Rohith45-ch/iitb/docs/3D_PRINTING_CHASSIS_AND_COMPONENTS_ARCHITECTURE.md

# 🖨️ 3D-Printed Multi-Deck Chassis & Component Architecture Blueprint
### Urban Autonomous Mobility Challenge (UAMC) — Techfest, IIT Bombay
**Repository:** [Rohith45-ch/iitb](https://github.com/Rohith45-ch/iitb)  
**Document File Path:** [`docs/3D_PRINTING_CHASSIS_AND_COMPONENTS_ARCHITECTURE.md`](file:///home/rohith/iitb/docs/3D_PRINTING_CHASSIS_AND_COMPONENTS_ARCHITECTURE.md)  
**Hardware Authority:** `Wiring_and_Pin_Map.pdf` (Repo: `Rohith45-ch/iitb`)  
**Revision:** 2.2 (Aligned to `Wiring_and_Pin_Map.pdf` · Outer/Base Layer Reprint Checklist · Corrected 170 mm Wheelbase)  
**Date:** November 7, 2026  

---

> [!IMPORTANT]
> This is a **preliminary layout guide**, not a print-ready CAD drawing. Measure the actual parts and resolve the items marked **NEEDS CONFIRMATION** before modeling or printing the full chassis.

> **Outer-layer reprint quick status — updated 2026-11-07:** Use the corrected **170 mm axle-center wheelbase**. Do not reuse the old 185 mm rear-axle position. Electrical placement is aligned to `/home/rohith/Downloads/Wiring_and_Pin_Map.pdf`: the 5 V buck powers the servo, sonar, and L298N logic; the power bank powers the Pi only; and the E-stop NC contact is before the fuse in the battery line. The outer/base layer may be reprinted only after checking the actual wheel track, steering clearance, motor mounting points, and battery footprint against the checklist in Section 2A.

---

## 2A. Outer/Base Layer Reprint Checklist

Use this checklist before exporting the outer/base layer STL. These are the current locked decisions and the remaining measurements that must come from the physical vehicle.

| Item | Current specification | Before printing |
|---|---|---|
| Wheelbase | **170.0 mm**, front axle center to rear axle center | Mark both axle centerlines in CAD; do not use 185 mm |
| Base envelope | **240 mm length × 110 mm width × 3.5 mm floor** | Treat as a starting envelope; verify wheel and motor overhang |
| Track width | Not safely fixed in the repository | Measure wheel-center to wheel-center and check full steering lock |
| Front servo mount | Raised mount or through-opening; no 18 mm-deep pocket in 3.5 mm floor | Measure the SG90/MG90S body, ears, horn, and linkage before cutting |
| Rear motor mounts | Actual TT motor and axle positions | Measure both motors and confirm wheel alignment/ground clearance |
| Battery cradle | Sized from the actual 3S battery, leads, and connector | Leave removal clearance; do not compress the pack |
| Layer-1 mounting bosses | Six M3 support bosses, 7 mm outer diameter / 3.2 mm hole | Confirm the upper-deck footprint fits the measured electronics |

**Minimum reprint gate:** confirm the 170 mm wheelbase, actual track width, front wheel sweep, servo clearance, and rear motor positions. If any of these are unknown, print a small fit-check piece or mark the part locations on the existing chassis before printing the complete outer layer.

---

## 📌 1. Executive Hardware Specification

### 📋 Reconciled Component Inventory & Placement

| Component | Physical Model / Specification | Deck Location | Role in Autonomous System |
| :--- | :--- | :--- | :--- |
| **High-Level SBC** | **Raspberry Pi 5 (8GB)** (85 × 56 mm) | **Layer 2** (Top Deck) | IPM Lane Tracking, YOLOv8/PilotNet AI, Behavior FSM Planner |
| **Vision Camera** | **Raspberry Pi Camera Rev 1.3** (OV5647 5MP) | **Layer 3** (Elevated Mast) | 120–150 mm elevation, 18° downward tilt, 15-to-22 pin CSI ribbon |
| **Low-Level MCU** | **ESP32 DevKit V1 (30-pin)** | **Layer 1** (Mid Deck) | 20 kHz motor PWM, 50 Hz servo PWM, sonar timing, 150ms watchdog |
| **Steering Actuator** | **Micro Servo 9g (SG90 / MG90S)** | **Layer 0** (Front Center) | Front Ackermann steering angle ($\pm 28^\circ$) via GPIO 18 |
| **Motor Driver** | **L298N Dual H-Bridge Module** | **Layer 1** (Mid Deck) | Drives both TT motors; PWM via GPIO 19, DIR via GPIO 22/23 |
| **Drive Motors** | **2× TT Gear Motors; exact model and stall current unknown** | **Layer 0** (Rear Axle) | Check each motor's voltage and stall current against the L298N and buck converter before driving |
| **Drive Battery** | **3S LiPo 2200 mAh (11.1V / 12.6V)** | **Layer 0** (Center Floor) | High-current main power source (lowest center of gravity) |
| **Motor Regulator** | **7V Buck Converter (3A+)** | **Layer 1** (Mid Deck) | Drops 3S pack to 7V for L298N motor supply (`+12V VS`) |
| **Logic Regulator** | **5V Buck Converter (3A+)** | **Layer 1** (Mid Deck) | Powers servo, HC-SR04 VCC, and L298N 5V logic; remove the L298N 5V jumper |
| **Pi Power Bank** | **2500–3500 mAh, 5V/3A listed output** | **Layer 1** (Mid Deck Rear) | Powers the Pi 5 only through USB-C; do not power the servo from the Pi GPIO header |
| **Obstacle Sonar** | **1× HC-SR04 Ultrasonic Sensor** | **Layer 2** (Front Bumper) | Front-center emergency braking pod (Trig: GPIO 5, Echo: GPIO 35) |
| **E-Stop Switch** | **22 mm Latching E-Stop (2 Contacts)** | **Layer 1/2** (Top Flange) | NC contact in battery line; NO contact to ESP32 GPIO 27 |
| **Inline Fuse** | **10A fuse — rating still needs checking against measured current and wire size** | **Layer 0/1** (next to battery positive terminal) | Protects the battery lead; fit after the E-stop in the positive wire |
| **Prototyping Deck** | **400-Point Solderless Breadboard** | **Layer 1** (Mid Deck) | ESP32 carrier, common GND rail, 1k/2k echo divider, servo cap |
| **Ground Line Sensor**| **SmartElex RLS-06 (6-IR Array)** | **Layer 0** (Under-Nose) | Optional ground recovery sensor (camera handles main lane tracking) |

---

## 📐 2. Master CAD Dimensioning & Fastener Schedule

Every dimension includes standard FDM 3D printing tolerances (+0.2 mm to +0.3 mm on inner diameters to ensure effortless fastener clearance and drop-in fit):

| Component | Physical Dimensions (L × W × H) | Mounting Pattern / Center-to-Center | Fastener Hardware | CAD Modeling Feature / Pocket Tolerances |
| :--- | :--- | :--- | :--- | :--- |
| **Chassis Wheelbase ($L$)** | **170.0 mm** (axle center to axle center; PDF specification) | Use front axle center as $y=0$; rear axle center must be $y=170.0\text{ mm}$ | Axle hardware depends on actual steering and motor parts | **NEEDS CONFIRMATION:** check against the physical chassis, wheels, and axle parts before CAD. |
| **Chassis Track Width ($W$)** | **NEEDS CONFIRMATION** | Measure between wheel centers on the actual chassis; do not use the unverified 135–145 mm range | Depends on actual wheels and axles | Check wheel clearance at full steering lock. |
| **Micro Servo 9g (SG90/MG90S)**| Measure the actual servo; listed body size is approximate | Use actual mounting ears and horn | Fasteners depend on servo ears | A simple 18 mm-deep pocket cannot be cut into the 3.5 mm floor. Design a raised mount or a through-opening with a separate holder; steering linkage geometry still needs to be designed. |
| **2× TT Gear Motors** | 70.0 × 22.0 × 19.0 mm each | 2 transverse bolt holes: **Ø 3.2 mm** | 2× M3 × 30 mm cross-bolts | Dual clamp saddle: **22.5 × 19.5 mm** pocket per motor. |
| **3S LiPo 2200 mAh Battery** | Measure pack including leads and connector | Floor cradle, positioned after deck layout | 20 mm Velcro cinch strap | **NEEDS CONFIRMATION:** set tray size and strap slots from the actual pack; leave room to connect and remove it without squeezing the battery. |
| **L298N Motor Driver** | 43.5 × 43.5 × 26.0 mm (with heatsink) | 4 holes: **37.5 × 37.5 mm** square pattern | 4× M3 × 8 mm standoffs | Clearance under board for solder tails; heatsink airflow slot. |
| **7V Buck Converter (Motor)** | Measure actual board; current rating must be verified | Use actual board holes or cable ties | M3 screws or zip-ties | Size tray from board; confirm converter handles both motors' stall current. |
| **5V Buck Converter (Logic)** | Measure actual board and confirm current rating | Use actual board holes or cable ties | M3 screws or zip-ties | Size tray from board; output supplies sonar and L298N logic. |
| **400-Point Breadboard** | 82.0 × 55.0 × 9.0 mm | Adhesive back foam pad | Recessed snap-lip | Tray: **83.5 × 56.5 × 3.0 mm** recessed well. |
| **ESP32 DevKit V1 (30-pin)** | 52.0 × 28.5 × 13.0 mm | 2.54 mm pitch (25.4 mm pin row span)| Press-fit into breadboard | Straddles center divider of breadboard; leave 2 rows free each side. |
| **Raspberry Pi 5 (8GB)** | 85.0 × 56.0 × 17.0 mm (24 mm w/ cooler) | 4 holes: **58.0 × 49.0 mm** rectangle | 4× M2.5 × 10 mm standoffs | Hole diameter: **Ø 2.8 mm**; bottom cutaway for MicroSD access. |
| **Raspberry Pi Camera Rev 1.3** | 25.0 × 24.0 × 9.0 mm (lens Ø 8.0 mm) | 4 holes: **21.0 × 12.5 mm** rectangle | 4× M2 nylon screws | Lens aperture: **Ø 9.0 mm**; bottom ribbon slot: **17.0 × 2.5 mm**. |
| **HC-SR04 Ultrasonic Module** | 45.0 × 20.0 × 15.0 mm (cylinders: Ø 16.0 mm)| Dual cylinder center spacing: **26.0 mm**| Front friction snap-fit | 2 barrel holes: **Ø 16.4 mm** spaced 26.0 mm on center. |
| **22 mm Latching E-Stop Switch**| Ø 22.0 mm threaded body, Ø 30 mm bezel | Single panel hole | Threaded locking ring | Flange hole: **Ø 22.5 mm**; prominent top-deck position. |
| **2500–3500 mAh LiPo Power Bank**| Measure actual bank | Flat rectangular pack | Straps sized to bank | **NEEDS CONFIRMATION:** size bay from the actual bank; it powers the Pi 5 only. |
| **SmartElex RLS-06 (Optional)** | 135.0 × 20.0 × 12.0 mm | 2 mounting holes: **125.0 mm** apart | 2× M3 screws + spacers | Under-nose bracket: **6.0 – 8.0 mm** track clearance. |

---

## 🏗️ 3. Multi-Deck Sandwich Architecture

The vehicle is partitioned into **4 vertical structural tiers** connected by M3 hexagonal standoffs. Keep signal wiring away from motor and battery wiring where practical; the tier layout alone does not eliminate electrical noise. The final deck arrangement must be checked against the actual component sizes:

```
===================================================================================
                       LAYER 3: VISION MAST (Height: 120–150 mm)
  [ Pi Camera Rev 1.3 ] (18° downward tilt, forward line of sight)
         │ 15-to-22 pin CSI ribbon cable
===================================================================================
                       LAYER 2: COMPUTE & SENSOR DECK (Top Plate)
  • Front Bumper: 1× HC-SR04 Ultrasonic Sonar Pod (Center 0°, GPIO 35 via divider)
  • Center Bay:   Raspberry Pi 5 (8GB) with Active Cooler (M2.5 standoffs)
  • Top Flange:   22 mm Latching E-Stop Kill Switch Button (High-visibility)
===================================================================================
                       LAYER 1: CONTROLLER & POWER REGULATION DECK
  • 400-Point Breadboard (Carries ESP32 DevKit V1 + Voltage Divider + 1000µF Cap)
  • L298N Dual H-Bridge Motor Driver Module (M3 standoffs, heatsink exposed)
  • 7V Buck Converter (Motor Rail) & 5V Buck Converter (Sonar/L298N Logic Rail)
  • 2500–3500 mAh LiPo Power Bank Cradle (Pi 5 only)
===================================================================================
                       LAYER 0: STRUCTURAL BASE CHASSIS (Bottom Floor)
  • Wheelbase: Exactly 170.0 mm (Axle to Axle)
  • Front Axle: Ackermann Steering Knuckles + Micro Servo 9g Pocket (23.5 × 12.5 mm)
  • Center Bay: 3S LiPo 2200 mAh Battery Cradle (Lowest vehicle center of gravity)
  • Rear Axle:  Dual TT Gear Motors (3–9V) clamped in transverse saddles
  • Under-Nose: SmartElex RLS-06 6-IR Ground Line Array (Optional add-on)
===================================================================================
```

---

## 🔍 4. Detailed Layer-by-Layer CAD Modeling Guide

### 🚗 Layer 0: Structural Base Chassis
1. **Perimeter Dimensions:**
   - Length: **240.0 mm**, Width: **110.0 mm**, Floor Plate Thickness: **3.5 mm** — preliminary envelope only; verify against the actual chassis and component layout.
   - Wheelbase: **170.0 mm axle-center to axle-center**, as specified in the PDF. Set the CAD origin at the front axle center ($y=0$) and place the rear axle center at $y=170.0$ mm. The previous rear axle position of $y=185$ mm was incorrect.
2. **Micro Servo 9g Steering Pocket:**
   - Position and orientation: **NEEDS CONFIRMATION** after the actual steering knuckles, wheels, servo, and horn are laid out.
   - Do not model the listed 18 mm depth as a recess in the 3.5 mm floor. Use a raised servo mount or an opening with a separate retaining bracket, sized from the actual servo.
   - Set mounting holes from the actual servo ears. Design the horn and tie rods so both front wheels turn without binding or tire rub through the required steering range.
3. **TT Gear Motor Clamps:**
   - Position: Rear axle centerline at $y = 170.0\text{ mm}$ from the front axle center.
   - Saddle locations and dimensions: **NEEDS CONFIRMATION** from the actual TT motors, axles, and wheels; check wheel alignment and ground clearance.
   - Dual M3 through-bolt channels (spacing **30.0 mm**) to clamp each motor firmly against torque reaction.
4. **3S LiPo Battery Tray:**
   - Position: Centerline at $y = 70.0\text{ mm}$ to $y = 150.0\text{ mm}$.
   - Internal well dimensions: **NEEDS CONFIRMATION** from the actual battery, including its lead and connector; allow clearance for removal and do not compress the pack.
   - Include 4 slots (**22.0 × 3.0 mm**) for standard 20 mm Velcro cinch straps.
5. **Deck Standoff Bosses:**
   - 6× M3 mounting bosses (Ø 7.0 mm outer, Ø 3.2 mm inner hole) located along perimeter rails to support Layer 1.

---

### ⚡ Layer 1: Controller & Power Deck (Mid Plate)
1. **Breadboard Well:**
   - Recessed tray: **83.5 mm × 56.5 mm × 2.5 mm depth**.
   - Mount 400-point breadboard using its adhesive backing.
   - ESP32 DevKit V1 plugs into breadboard straddling the center divider groove.
2. **L298N Motor Driver Mounting:**
   - Footprint: **44.0 × 44.0 mm** area.
   - 4× M3 standoff holes on a **37.5 × 37.5 mm** square grid.
   - Provide a **20 × 20 mm central cutout** beneath the board for terminal soldering pin relief and convection cooling.
3. **Dual Buck Converter Trays (7V and 5V):**
   - Side-by-side cradles: each **68.0 × 38.0 mm**.
   - M3 mounting holes or cable-tie anchor channels.
   - Leave clearance around multiturn trim pots so output voltages can be adjusted with a screwdriver while mounted.
4. **Power Bank Tray:**
   - Size from the actual power bank. Leave USB-C connector and cable access, strap space, and room to remove the bank.
5. **Full deck fit check:**
   - The breadboard, L298N, two buck converters, and Pi power bank are listed for Layer 1, but their placement has not been checked. Make a top-view layout from measured part outlines before fixing the deck outline or printing it.
5. **E-Stop Panel Flange:**
   - Raised rear/side boss with a **Ø 22.5 mm** clearance hole for the 22 mm latching emergency kill button.

---

### 🧠 Layer 2: Compute & Sensor Deck (Top Plate)
1. **Raspberry Pi 5 Standoff Posts:**
   - 4× raised cylindrical posts (height 6.0 mm, outer Ø 6.0 mm).
   - Hole pattern: **58.0 mm × 49.0 mm** rectangle with **Ø 2.8 mm** holes for M2.5 brass standoffs.
   - Provide a **30.0 × 15.0 mm rectangular cutaway** underneath the MicroSD card slot for easy card insertion/removal without removing the board.
2. **Front Bumper & Ultrasonic Pod:**
   - Integrated forward curved bumper extending 25 mm ahead of front wheels.
   - Two cylindrical bores: **Ø 16.4 mm**, center-to-center distance **26.0 mm**, wall thickness 2.0 mm.
   - Rear access pocket allowing the 4-pin right-angle header of the HC-SR04 to plug in cleanly.

---

### 📷 Layer 3: Vision Mast & Camera Bracket
1. **Mast Structure:**
   - Rigid A-frame or hollow rectangular tower (height **130.0 mm**, base width **45.0 mm**).
   - Central internal channel (**20.0 × 4.0 mm**) to route the delicate CSI ribbon cable safely away from tire spray.
2. **Pi Camera Rev 1.3 Faceplate:**
   - Dimensions: **30.0 × 30.0 mm** angled faceplate with fixed **18.0° downward tilt**.
   - 4× M2 screw holes on a **21.0 × 12.5 mm** grid.
   - Center lens aperture: **Ø 9.0 mm**.
   - Bottom slot (**18.0 × 2.5 mm**) for 15-pin ribbon exit.

---

## 🔌 5. Master Wiring & Electrical Interconnect Schematic

```
                         ┌────────────────────────────────────────┐
                         │   2500–3500 mAh LiPo Power Bank        │
                         └───────────────────┬────────────────────┘
                              │ 5V / 3A USB-C
                              ▼
                     [ Raspberry Pi 5 ]
                                             │
                                USB Cable    │   15-to-22 Pin Ribbon
                              (Serial Data)  │
                                             ▼
                      ┌──────────────────────┴──────────────────────┐
                      │                                             │
                      ▼                                             ▼
            [ ESP32 DevKit V1 ]                          [ RPi Cam Rev 1.3 ]
         (on 400-pt Breadboard)                         (on Layer 3 Mast)
          ├── GPIO 18 (PWM 50Hz) ──────► Micro Servo 9g (Signal)
          ├── GPIO 19 (PWM 20kHz) ─────► L298N ENA + ENB (Speed)
          ├── GPIO 22 (Digital Out) ───► L298N IN1 + IN3 (Dir A)
          ├── GPIO 23 (Digital Out) ───► L298N IN2 + IN4 (Dir B)
          ├── GPIO 5  (Trigger)  ──────► HC-SR04 Center Sonar Trig
          ├── GPIO 35 (Echo Center)◄─── HC-SR04 Center Sonar Echo (via 1k/2k Divider)
          └── GPIO 27 (Input Pullup)◄── Hardware E-Stop Switch (Active-LOW)

┌────────────────────────────────────────────────────────────────────────┐
│                      3S LiPo 2200 mAh (11.1V / 12.6V)                  │
└───────────────────────────────────┬────────────────────────────────────┘
                                    │ (+) Positive Wire
                                    ▼
                         [ E-Stop Switch NC Contact ]
                                    │
                                    ▼
                         [ 10A Inline Fuse ]
                                    │
               ┌────────────────────┴────────────────────┐
               │                                         │
               ▼                                         ▼
       [ 7V Buck Converter ]                     [ 5V Buck Converter ]
       (Adjusted to 7.00V)                       (Adjusted to 5.00V)
               │                                         │
               ▼                                         ├──► Servo (+) + 470–1000µF capacitor
       L298N +12V (VS) Terminal                    ├──► HC-SR04 VCC (5V)
               │                                         └──► L298N +5V Logic [Jumper Removed]
               ▼
     [ Left & Right TT Motors ]

Power-bank ground, Pi ground, ESP32 ground (through USB), L298N ground, buck grounds, servo ground, and sonar ground must be common. The 3S LiPo positive path is: E-stop NC contact, then 10 A fuse, then the buck converters.
```

> **Power checks still required:** The Pi power bank is Pi-only. The 5 V buck must power the servo, HC-SR04, and L298N logic. The E-stop must cut all motor-battery-powered rails because its NC contact is before the fuse. Measure motor stall current and verify driver, converter, wiring, fuse, and switch ratings. The listed 10 A fuse is not confirmed until those ratings are checked.

---

## 🖨️ 6. 3D Print Manufacturing Slicing Profile

| Slicer Parameter | Recommended Value | Engineering Justification |
| :--- | :--- | :--- |
| **Material / Filament** | **PETG** (or **PLA+**) | Heat resistance near motors (>75°C vs PLA's 55°C deformation) and high layer impact toughness. |
| **Layer Height** | **0.20 mm** (0.28 mm for draft) | Smooth surface finish for screw threads and tight tolerance on sensor pockets. |
| **Perimeter Walls** | **4 to 5 walls (1.6 – 2.0 mm)** | **Critical:** Screws thread directly into 3D-printed plastic walls; 2 walls will strip immediately. |
| **Top & Bottom Layers** | **4 Top / 4 Bottom** | Prevents deck flexing under battery and motor clamping loads. |
| **Infill Density** | **35% – 45%** | Maximizes torsional stiffness to ensure accurate steering geometry. |
| **Infill Pattern** | **Gyroid** or **Cubic** | Uniform 3-dimensional stress resistance without directional failure planes. |
| **Supports** | Tree / Organic Supports | Enable only for overhang angles > 55° (camera tilt bracket and bumper curvature). |
| **Print Bed Adhesion** | Textured PEI sheet with 5 mm Brim | Prevents corner lifting / warping on the long 240 mm chassis baseplate. |

---

## 🚀 7. Step-by-Step Mechanical Assembly Sequence

### Phase 1: Base Chassis Build (Layer 0)
1. **Fit Steering Servo:** Install the servo in the raised mount or separate holder designed to fit the measured servo. Attach the horn at neutral and connect the designed tie rods. Check that neither front wheel binds or rubs at full steering lock.
2. **Mount TT Motors:** Insert the two TT gear motors into the rear axle saddles. Insert 2× M3 × 30 mm cross-bolts per motor and tighten nylon locknuts. Press rear drive wheels onto motor double-flat axles.
3. **Install Drive Battery:** Place the 3S LiPo 2200 mAh into the central cradle. Cinch securely with a 20 mm Velcro strap.
4. **Install Standoffs:** Thread 6× M3 × 30 mm female-female hex standoffs into the perimeter bosses.

### Phase 2: Power & Controller Deck Assembly (Layer 1)
1. **Install Mid Plate:** Place the Layer 1 plate over the standoffs and secure with M3 countersunk screws.
2. **Mount Breadboard & ESP32:** Peel the adhesive backing off the 400-point breadboard and press it into the recessed tray. Seat the ESP32 DevKit V1 straddling the center channel.
3. **Mount L298N & Bucks:** Fasten the L298N module using 4× M3 × 8 mm standoffs. Fasten both buck converters into their trays using zip-ties or M3 screws.
4. **Wire Power & E-Stop:** Install the 22 mm E-Stop button in the flange hole. Wire the battery positive through the E-stop NC contact first, then through the fuse placed close to the battery. Wire the NO contact to ESP32 GPIO 27. Confirm the fuse and switch ratings against the actual wiring and motor current before use.
5. **Adjust Buck Voltages:** Connect battery and use a multimeter to adjust the 7V buck to **7.00V** and the 5V buck to **5.00V** before making connections to components.
6. **Install Upper Standoffs:** Thread 4× M3 × 35 mm hex standoffs into the Layer 1 top bosses.

### Phase 3: Compute & Vision Deck Assembly (Layer 2 & 3)
1. **Mount Ultrasonic Sensor:** Push the HC-SR04 barrels into the front bumper holes until seated flush. Wire TRIG to ESP32 GPIO 5 and ECHO through the 1kΩ/2kΩ divider to GPIO 35.
2. **Mount Raspberry Pi 5:** Bolt the Pi 5 to the 4× M2.5 standoffs. Ensure the Active Cooler is mounted and the MicroSD card is accessible.
3. **Assemble Camera Mast:** Bolt the Layer 3 camera mast to the front of Layer 2. Fasten the Pi Camera Rev 1.3 to the 18° tilted faceplate using 4× M2 nylon screws.
4. **Route Camera Ribbon:** Route the 15-to-22 pin CSI adapter cable down through the mast channel and connect it to Pi 5 port `CAM1`.

### Phase 4: Final Interconnect & Verification
1. **Connect Data Link:** Plug a short USB-A to Micro-USB cable between a Pi 5 USB-A port and the ESP32 Micro-USB port.
2. **Connect Actuator Jumpers:** Wire GPIO 18 to Servo Signal; GPIO 19 to L298N ENA+ENB; GPIO 22 to IN1+IN3; GPIO 23 to IN2+IN4.
3. **Common Ground Verification:** Confirm with a continuity meter that ESP32 GND, L298N GND, battery (−), and buck GNDs are all connected.
4. **Execute Pre-Flight Diagnostic:**
   ```bash
   ssh rohith@10.94.129.58
   cd ~/iitb && git pull origin main
   python3 scripts/detect_hardware.py
   python3 scripts/verify_system_ready.py
   ```
