Rohith45-ch/iitb/docs/ROUND1_ARCHITECTURE_AND_BUILD_GUIDE.md

# 🏛️ Round 1 Complete System Architecture & Build Guide
### Urban Autonomous Mobility Challenge (UAMC) — Techfest, IIT Bombay
**Vehicle Model:** AML-Rover-V1  
**Target:** Round 1 Qualification (Top 25 Teams)  
**Hardware Profile:** Raspberry Pi 5 (8GB) + ESP32 DevKit V1 + L298N + 2× TT Gear Motors + 3S LiPo 2200mAh + Single Camera + HC-SR04  

---

## 1. Executive Summary & Objective

This document defines the complete end-to-end hardware and software architecture specifically optimized for **Round 1 of the Urban Autonomous Mobility Challenge (UAMC)**.

For Round 1, the competition demands demonstrating:
1. **Autonomous Lane Following:** Continuous centering between white/yellow road markings without crossing lane boundaries.
2. **Controlled Obstacle Halt:** Smooth deceleration and stopping before a static obstacle (> 15 cm clearance) with zero remote intervention.
3. **Safety Watchdog / E-Stop:** Demonstrable emergency stop capability.

This architecture runs **100% on the hardware you currently have in hand**, eliminating non-essential components (such as the MPU6050 IMU and Logic Level Shifter) for this stage, ensuring zero blocking dependencies.

---

## 2. End-to-End Architecture Diagram

```mermaid
flowchart TD
    subgraph Power["⚡ Power Subsystem"]
        BAT["3S LiPo 2200 mAh (11.1V nominal)"] -->|"NC contact → 10A Fuse"| BUCK7["7V Buck Converter"]
        BAT -->|"NC contact → 10A Fuse"| BUCK5["5V Buck Converter"]
        PB["5V 3A+ Power Bank"] -->|"USB-C Cable"| RPI["Raspberry Pi 5 (8GB)"]
        BUCK7 -->|"Motor Supply"| L298N["L298N Motor Driver"]
        BUCK5 -->|"Logic + Servo + Sonar"| SERVO["Steering Servo SG90/MG90S"]
        BUCK5 -->|"5V VCC"| HC["HC-SR04 Ultrasonic"]
        BUCK5 -->|"Logic 5V (jumper removed)"| L298N
    end

    subgraph RPi5["🧠 High-Level Compute (Raspberry Pi 5)"]
        CAM["Pi Camera Rev 1.3 (CSI)"] -->|"OpenCV (640x480 @ 30 FPS)"| PERC["Perception Engine"]
        PERC --> IPM["Lane Detector (IPM + Polyfit)"]
        PERC --> AI["Lightweight AI / Rule-Based Detector"]
        IPM & AI --> FSM["Behavior Planner (FSM)"]
        FSM --> CTRL["Pure Pursuit + Longitudinal PID"]
        CTRL --> BRIDGE["Serial Bridge (USB, /dev/ttyUSB0)"]
    end

    subgraph ESP32["⚡ Low-Level Real-Time Controller (ESP32 DevKit V1)"]
        CORE0["Core 0: Sensor Processing\n(Median-5 + EMA Filter)"]
        CORE1["Core 1: Actuation & Safety\n(20kHz L298N PWM + 150ms E-Stop Watchdog)"]
    end

    subgraph ActuatorsSensors["🚗 Vehicle Chassis & Actuation"]
        HC -->|"Echo (GPIO35 via divider) / Trig (GPIO5)"| CORE0
        CORE1 -->|"20 kHz PWM GPIO19 → ENA/ENB"| L298N
        CORE1 -->|"DIR_A GPIO22, DIR_B GPIO23"| L298N
        CORE1 -->|"50 Hz PWM GPIO18"| SERVO
        L298N -->|"OUT1/2 Left Motor"| MOTL["Left TT Gear Motor"]
        L298N -->|"OUT3/4 Right Motor"| MOTR["Right TT Gear Motor"]
    end

    BRIDGE <== "USB-A to Micro-USB Cable\n(/dev/ttyUSB0 @ 115200 baud)" ==> CORE1
```

---

## 3. Hardware Wiring & Electrical Pinout

The connection between the Raspberry Pi 5 and ESP32 DevKit is handled over a standard **USB-A to Micro-USB cable**, which handles both data communication and 5V power for the ESP32.

### A. Power Distribution Architecture
| Power Source | Consumer | Voltage / Current | Purpose |
| :--- | :--- | :--- | :--- |
| **3S LiPo 2200 mAh** | 7V Buck Converter → L298N +12V(VS) | 11.1V nominal, set buck to 7V | High-current TT motor supply |
| **5V Buck Converter** | Steering Servo | 5.0V regulated | Powers servo (+ 470-1000µF cap) and HC-SR04; L298N logic |
| **5V 3A+ Power Bank** | Raspberry Pi 5 | 5.0V USB-C | Clean isolated power for Pi 5 compute and camera |
| **Raspberry Pi 5 USB Port** | ESP32 Micro-USB | 5.0V USB VBUS | Powers ESP32 logic and sensor rail |

### B. ESP32 Pin Connections
| Component | Signal Name | ESP32 Pin | Function / Protocol |
| :--- | :--- | :--- | :--- |
| **Steering Servo** | PWM Signal (White/Orange) | **GPIO 18** | 50 Hz PWM (`LEDC_CHANNEL_0`) |
| **Steering Servo** | Ground (Black/Brown) | **GND** | Common Ground |
| **L298N ENA + ENB | PWM Speed (20 kHz) | GPIO 19 | 20 kHz PWM (LEDC_CHANNEL_1, 0–255 duty)) |
| **L298N GND** | Ground | **GND** | Common Ground — must join all other GNDs |
| **HC-SR04 Ultrasonic** | VCC | **VIN (5V)** | Ultrasonic 5V supply |
| **HC-SR04 Ultrasonic** | GND | **GND** | Ground |
| **HC-SR04 Ultrasonic** | Trigger | **GPIO 5** | 10 µs Trigger Pulse (`PIN_US_TRIG`) |
| **HC-SR04 Ultrasonic** | Echo | **GPIO 35** | Center Front Echo Return (`PIN_US_ECHO_CENTER`) |

---

## 4. Software Stack & Data Contracts

```mermaid
sequenceDiagram
    participant Cam as USB Camera
    participant RPi as Raspberry Pi 5 (Python)
    participant USB as USB Serial Bridge (115200)
    participant ESP as ESP32 (FreeRTOS)
    participant HW as Servo & L298N

    loop 30 Hz Control Loop
        Cam->>RPi: Capture Raw Frame (640x480 @ 30 FPS)
        RPi->>RPi: 1. IPM Perspective Warp & Color Masking<br>2. Centerline Polynomial Fit<br>3. Compute Target Steering Angle & Target Speed
        ESP->>USB: Send Telemetry `#TEL,<dist_l>,<dist_c>,<dist_r>,<yaw>,<estop>*`
        USB->>RPi: Parse Ultrasonic Distance (< 20 cm triggers Stop FSM)
        RPi->>USB: Send Command `#CMD,<steer_norm>,<throttle_norm>,<estop_flag>*`
        USB->>ESP: ESP32 Core 1 Decodes Packet
        ESP->>HW: Write 50 Hz PWM to Servo (GPIO 18); 20 kHz PWM to L298N ENA/ENB (GPIO 19) + DIR_A/B (GPIO 22/23)
    end
```

### Serial Packet Protocol
* **Raspberry Pi → ESP32 Command (`#CMD`):**
  ```text
  #CMD,<steering_normalized>,<throttle_normalized>,<estop_flag>*\n
  ```
  * `steering_normalized`: Float from `-1.0` (Full Left) to `+1.0` (Full Right).
  * `throttle_normalized`: Float from `-1.0` (Full Reverse/Brake) to `+1.0` (Full Forward).
  * `estop_flag`: Integer `0` (Normal operation) or `1` (Emergency Stop).

* **ESP32 → Raspberry Pi Telemetry (`#TEL`):**
  ```text
  #TEL,<dist_left>,<dist_center>,<dist_right>,<dist_side>,<enc_left>,<enc_right>,<yaw>,<estop>*\n
  ```
  * Distances in meters (filtered via 5-sample median filter + EMA).
  * `estop`: `1` if the 150 ms hardware watchdog triggered or hardware stop activated.

---

## 5. Step-by-Step Round 1 Bring-Up Plan

### Step 1: Upload Firmware to ESP32
1. Connect ESP32 DevKit to laptop using the Micro-USB cable.
2. Open `firmware/esp32_firmware/esp32_vehicle_controller.ino` in Arduino IDE.
3. Select Board: **ESP32 Dev Module** and correct serial port.
4. Click **Upload** and verify `Flash done`.

### Step 2: Calibrate Camera on Vehicle
1. Place vehicle on flat floor with marked lane lines ($35\text{ cm}$ apart).
2. Run camera calibration utility:
   ```bash
   python3 scripts/calibrate_camera.py --camera-id 0
   ```
3. Adjust IPM trapezoid coordinates to generate parallel lane lines in bird's-eye view. Values automatically save to `config/rpi_tuning.py`.

### Step 3: Run Full System Verification
Connect the ESP32 to the Raspberry Pi 5 USB port and execute:
```bash
python3 scripts/detect_hardware.py
python3 scripts/verify_system_ready.py
```
Verify that all 5 stages report `[PASS]`.

### Step 4: Record Qualification Video
Run the qualification telemetry video recorder:
```bash
python3 scripts/record_qualification_run.py --output-video round1_submission.mp4
```
This records real-time camera footage with superimposed steering angles, detected lane polynomials, and ultrasonic distance telemetry suitable for the Round 1 submission video.

---

## 6. Strategic Recommendations & Enhancements

### 💡 A. Recommended AI Module Selection for Round 1
| Vision Approach | Computational Load on Pi 5 | Recommendation | Rationale |
| :--- | :---: | :---: | :--- |
| **Classical CV (IPM + Polyfit)** | **~5% CPU (60+ FPS)** | 🟢 **Primary Driver** | Deterministic, highly robust on tape tracks, zero frame lag. Ideal for smooth lane tracking. |
| **YOLOv8-Nano (`models/yolov8n.onnx`)** | **~25% CPU (25–30 FPS)** | 🟡 **Optional Secondary** | Run concurrently for obstacle and sign identification. Pre-converted and verified in the repo. |
| **PilotNet (`models/pilotnet_steering.onnx`)** | **~10% CPU (45 FPS)** | ⚪ **Defer to Round 2** | Neural steering requires extensive track-specific behavioral cloning data. |

> **Best Approach for Round 1:** Use **Classical IPM Lane Detection** for primary steering and **Ultrasonic sensing** for obstacle stopping. This guarantees top-tier reliability for the qualifying video.

---

### 💡 B. Software Enhancements to Insert
1. **Auto-Start on Boot (Systemd Service):**
   * Configure a systemd service (`uamc_autostart.service`) to start `run_autonomous.py` automatically on boot when the vehicle power bank is plugged in, eliminating the need for laptop SSH during video recording.
2. **Web-Based Live Telemetry Stream:**
   * Run a lightweight MJPEG stream on port `8080` so team members can inspect the vehicle's perspective live from any smartphone connected to the Pi's Wi-Fi hotspot.

---

### 💡 C. Hardware Upgrades: Round 1 vs. Round 2 (On-Site Finals)
1. **Round 1 (Immediate - Confirmed In Hand):**
   * Raspberry Pi 5 + ESP32 DevKit v1 + USB Cable.
   * Single front HC-SR04 ultrasonic sensor.
   * Steering servo (SG90/MG90S) + L298N + 2x TT Gear Motors + 3S LiPo 2200mAh + 7V buck + 5V buck + 5V Power Bank.
2. **Round 2 (On-Site Finals at IIT Bombay):**
   * **MPU6050 IMU:** Add to ESP32 I²C bus (`SDA=GPIO 21`, `SCL=GPIO 22`) for slip compensation and yaw gyro integration.
   * **BSS138 Bidirectional Logic Level Shifter:** Place between HC-SR04 Echo pins (5V) and ESP32 GPIOs (3.3V) for long-term electrical safety.
   * **Optical Wheel Encoders:** Attach to rear drive axle for dead-reckoning odometry when crossing unmarked intersections.
