Rohith45-ch/iitb/firmware/esp32_firmware/esp32_vehicle_controller.ino

/*
  Urban Autonomous Mobility Challenge (UAMC) - ESP32 Real-Time Vehicle Controller
  Platform: ESP32 (Dual-Core 240MHz, FreeRTOS)
  Target: UAMC 1:10 Autonomous Vehicle

  Architecture:
  - Core 0: Non-blocking ultrasonic ranging, encoder tracking, and telemetry formatting.
  - Core 1: High-speed UART communication, watchdog monitor, and high-frequency PWM actuation.
*/

#include <Arduino.h>
#include "esp32_config.h"
#include "tinyml_motion.h"
#include "ultrasonic_filter.h"

// ==========================================
// SHARED STATE & THREAD SYNCHRONIZATION
// ==========================================
volatile long encoderTicksLeft = 0;
volatile long encoderTicksRight = 0;
portMUX_TYPE muxEncoder = portMUX_INITIALIZER_UNLOCKED;

volatile float g_us_left = 2.0f;
volatile float g_us_center = 2.0f;
volatile float g_us_right = 2.0f;
volatile float g_us_side = 0.20f;
volatile bool g_estop_button_pressed = false;

// Edge AI & Outlier Filter Instances
UltrasonicFilter filterLeft;
UltrasonicFilter filterCenter;
UltrasonicFilter filterRight;
UltrasonicFilter filterSide;
TinyMLMotionClassifier motionClassifier;
volatile VehicleMotionState g_motion_state = MOTION_NOMINAL;

// Command Watchdog State
volatile unsigned long lastCommandMillis = 0;
volatile bool watchdogTripped = false;

// ==========================================
// INTERRUPT SERVICE ROUTINES (ISRs)
// ==========================================
void IRAM_ATTR isrEncoderLeft() {
  portENTER_CRITICAL_ISR(&muxEncoder);
  encoderTicksLeft++;
  portEXIT_CRITICAL_ISR(&muxEncoder);
}

void IRAM_ATTR isrEncoderRight() {
  portENTER_CRITICAL_ISR(&muxEncoder);
  encoderTicksRight++;
  portEXIT_CRITICAL_ISR(&muxEncoder);
}

// ==========================================
// ACTUATOR OUTPUT FUNCTIONS
// ==========================================
void setSteeringNormalized(float norm) {
  // norm is in [-1.0 (left), +1.0 (right)]
  norm = constrain(norm, -1.0f, 1.0f);
  // Map norm to microseconds [1000us - 2000us]
  float us = SERVO_MID_US + (norm * (SERVO_MAX_US - SERVO_MID_US));
  // Convert us to LEDC 16-bit duty cycle at 50Hz (Period = 20,000 us)
  // duty = (us / 20000) * 65535
  uint32_t duty = (uint32_t)((us / 20000.0f) * 65535.0f);
  ledcWrite(PIN_STEER_SERVO, duty);
}

void setMotorThrottle(float norm) {
  norm = constrain(norm, -1.0f, 1.0f);

#if USE_ESC_MOTOR_DRIVER
  // Standard RC ESC: 50 Hz PWM with 1000us - 2000us pulse width
  float us = ESC_NEUTRAL_US;
  if (abs(norm) < ESC_DEADBAND_NORM) {
    us = ESC_NEUTRAL_US;
  } else if (norm > 0.0f) {
    // Forward mapping from neutral up to safe forward speed limit
    us = ESC_NEUTRAL_US + (norm * (ESC_FORWARD_SAFE_CAP_US - ESC_NEUTRAL_US));
  } else {
    // Reverse / Dynamic Braking
    us = ESC_NEUTRAL_US + (norm * (ESC_NEUTRAL_US - ESC_REVERSE_MAX_US));
  }
  // Convert microseconds to 16-bit LEDC duty at 50 Hz (20,000 us period)
  uint32_t duty = (uint32_t)((us / 20000.0f) * 65535.0f);
  ledcWrite(PIN_MOTOR_PWM, duty);

#else
  // L298N Dual-wire H-Bridge (USE_ESC_MOTOR_DRIVER == 0)
  // Scaling accounts for MOTOR_MIN_START_PWM to overcome TT gearbox static friction
  if (abs(norm) < 0.05f) {
    digitalWrite(PIN_MOTOR_DIR_A, LOW);
    digitalWrite(PIN_MOTOR_DIR_B, LOW);
    ledcWrite(PIN_MOTOR_PWM, 0);
  } else if (norm > 0.0f) {
    // Forward: IN1/IN3 HIGH, IN2/IN4 LOW
    digitalWrite(PIN_MOTOR_DIR_A, HIGH);
    digitalWrite(PIN_MOTOR_DIR_B, LOW);
    uint32_t pwm = (uint32_t)(MOTOR_MIN_START_PWM + norm * (MOTOR_MAX_SAFE_PWM - MOTOR_MIN_START_PWM));
    pwm = constrain(pwm, 0, MOTOR_MAX_SAFE_PWM);
    ledcWrite(PIN_MOTOR_PWM, pwm);
  } else {
    // Reverse: IN1/IN3 LOW, IN2/IN4 HIGH
    digitalWrite(PIN_MOTOR_DIR_A, LOW);
    digitalWrite(PIN_MOTOR_DIR_B, HIGH);
    uint32_t pwm = (uint32_t)(MOTOR_MIN_START_PWM + abs(norm) * (MOTOR_MAX_SAFE_PWM - MOTOR_MIN_START_PWM));
    pwm = constrain(pwm, 0, MOTOR_MAX_SAFE_PWM);
    ledcWrite(PIN_MOTOR_PWM, pwm);
  }
#endif
}

// ==========================================
// CORE 0 TASK: SENSOR ACQUISITION
// ==========================================
float readUltrasonic(int echoPin) {
  digitalWrite(PIN_US_TRIG, LOW);
  delayMicroseconds(2);
  digitalWrite(PIN_US_TRIG, HIGH);
  delayMicroseconds(10);
  digitalWrite(PIN_US_TRIG, LOW);

  long duration = pulseIn(echoPin, HIGH, 20000); // 20ms timeout (~3.4m)
  if (duration <= 0) return 3.0f;
  return (duration * 0.0343f) / 200.0f;
}

void TaskSensorAcquisition(void *pvParameters) {
  while (true) {
#if SINGLE_CENTER_SONAR_ONLY
    // PDF §1, §3, §6 item 4, §7: Only single Center Sonar fitted.
    // Unfitted sonars (left, right, side) are bypassed to avoid 60ms timeout lag and floating-pin false stops.
    float raw_c = readUltrasonic(PIN_US_ECHO_CENTER);
    g_us_center = filterCenter.filter(raw_c);
    g_us_left = 3.0f;
    g_us_right = 3.0f;
    g_us_side = 3.0f;
    vTaskDelay(pdMS_TO_TICKS(30));
#else
    // Multi-sonar mode (when all 4 sensors are physically wired)
    float raw_l = readUltrasonic(PIN_US_ECHO_LEFT);
    g_us_left = filterLeft.filter(raw_l);
    vTaskDelay(pdMS_TO_TICKS(10));

    float raw_c = readUltrasonic(PIN_US_ECHO_CENTER);
    g_us_center = filterCenter.filter(raw_c);
    vTaskDelay(pdMS_TO_TICKS(10));

    float raw_r = readUltrasonic(PIN_US_ECHO_RIGHT);
    g_us_right = filterRight.filter(raw_r);
    vTaskDelay(pdMS_TO_TICKS(10));

    float raw_s = readUltrasonic(PIN_US_ECHO_SIDE);
    g_us_side = filterSide.filter(raw_s);
    vTaskDelay(pdMS_TO_TICKS(10));
#endif

    // 2. Hardware Emergency Stop button (PDF §3, §6 item 6: active-LOW)
    g_estop_button_pressed = (digitalRead(PIN_ESTOP_INPUT) == LOW);

    // 3. TinyML Collision & Rollover Check (100 Hz baseline)
    g_motion_state = motionClassifier.classify(0.0f, 0.0f, 1.0f, 0.0f, 0.0f);
  }
}

// ==========================================
// SETUP & CORE 1 (MAIN LOOP)
// ==========================================
void setup() {
  // Primary Serial for USB debug & secondary for RPi UART
  Serial.begin(115200);
  Serial2.begin(115200, SERIAL_8N1, PIN_UART_RX, PIN_UART_TX);

  // E-Stop Pin Setup (PDF §6 item 6: internal pullup + external 10k to 3.3V)
  pinMode(PIN_ESTOP_INPUT, INPUT_PULLUP);

  // Ultrasonic GPIO Setup (PDF §3: Pin 5 TRIG out, Pin 35 ECHO in via 1k/2k divider)
  pinMode(PIN_US_TRIG, OUTPUT);
  digitalWrite(PIN_US_TRIG, LOW);
  pinMode(PIN_US_ECHO_CENTER, INPUT);

  // Actuator LEDC Setup (Arduino-ESP32 v3.x API: ledcAttach replaces ledcSetup+ledcAttachPin)
  ledcAttach(PIN_STEER_SERVO, SERVO_LEDC_FREQ, SERVO_LEDC_RES);

#if USE_ESC_MOTOR_DRIVER
  // 1/10 RC ESC Setup: 50 Hz, 16-bit LEDC on Pin 19
  ledcAttach(PIN_MOTOR_PWM, ESC_LEDC_FREQ, ESC_LEDC_RES);

  // Arm ESC by outputting neutral pulse (1500 us)
  setSteeringNormalized(0.0f);
  setMotorThrottle(0.0f);
  Serial.println(F("[ESP32] Arming ESC (1500us neutral calibration)..."));
  delay(1500);
  Serial.println(F("[ESP32] ESC armed and vehicle ready."));
#else
  // L298N Dual H-Bridge Setup (USE_ESC_MOTOR_DRIVER == 0, per PDF §3, §5, §6)
  pinMode(PIN_MOTOR_DIR_A, OUTPUT);
  pinMode(PIN_MOTOR_DIR_B, OUTPUT);
  digitalWrite(PIN_MOTOR_DIR_A, LOW);
  digitalWrite(PIN_MOTOR_DIR_B, LOW);
  ledcAttach(PIN_MOTOR_PWM, MOTOR_LEDC_FREQ, MOTOR_LEDC_RES);
  setSteeringNormalized(0.0f);
  setMotorThrottle(0.0f);
  Serial.println(F("[ESP32] L298N Motor Driver configured (20 kHz PWM on Pin 19)."));
#endif

  // Encoders (PDF §6 item 5: only attach if physically fitted)
#if ENABLE_WHEEL_ENCODERS
  pinMode(PIN_ENCODER_LEFT, INPUT_PULLUP);
  pinMode(PIN_ENCODER_RIGHT, INPUT_PULLUP);
  attachInterrupt(digitalPinToInterrupt(PIN_ENCODER_LEFT), isrEncoderLeft, RISING);
  attachInterrupt(digitalPinToInterrupt(PIN_ENCODER_RIGHT), isrEncoderRight, RISING);
#endif

  // Launch Core 0 Sensor Task (Pinned to Core 0)
  xTaskCreatePinnedToCore(
    TaskSensorAcquisition,
    "SensorTask",
    4096,
    NULL,
    1,
    NULL,
    0
  );

  lastCommandMillis = millis();
}

unsigned long lastTelemetryMillis = 0;

void loop() {
  // 1. Process Incoming Commands from Raspberry Pi
  Stream &comm = Serial2.available() ? Serial2 : Serial;

  if (comm.available()) {
    String line = comm.readStringUntil('\n');
    line.trim();

    if (line.startsWith("#CMD,") && line.endsWith("*")) {
      String payload = line.substring(5, line.length() - 1);
      int c1 = payload.indexOf(',');
      int c2 = payload.indexOf(',', c1 + 1);

      if (c1 > 0 && c2 > 0) {
        float steer = payload.substring(0, c1).toFloat();
        float throttle = payload.substring(c1 + 1, c2).toFloat();
        int estop = payload.substring(c2 + 1).toInt();

        bool motionAnomaly = (g_motion_state == MOTION_COLLISION_DETECTED || g_motion_state == MOTION_ROLLOVER_DETECTED);
        if (estop == 1 || g_estop_button_pressed || motionAnomaly) {
          setMotorThrottle(0.0f);
          setSteeringNormalized(0.0f);
        } else {
          setSteeringNormalized(steer);
          setMotorThrottle(throttle);
        }

        lastCommandMillis = millis();
        watchdogTripped = false;
      }
    }
  }

  // 2. Hardware Watchdog Check
  if (millis() - lastCommandMillis > WATCHDOG_TIMEOUT_MS) {
    setMotorThrottle(0.0f);
    setSteeringNormalized(0.0f);
    watchdogTripped = true;
  }

  // 3. Telemetry Transmission to Raspberry Pi at 30 Hz
  if (millis() - lastTelemetryMillis >= 33) {
    lastTelemetryMillis = millis();

    long encL, encR;
    portENTER_CRITICAL(&muxEncoder);
    encL = encoderTicksLeft;
    encR = encoderTicksRight;
    portEXIT_CRITICAL(&muxEncoder);

    bool isEstop = (g_estop_button_pressed || watchdogTripped ||
                    g_motion_state == MOTION_COLLISION_DETECTED ||
                    g_motion_state == MOTION_ROLLOVER_DETECTED);

    // Packet: #TEL,<us_l>,<us_c>,<us_r>,<us_s>,<enc_l>,<enc_r>,<yaw>,<estop>*
    String telem = "#TEL,";
    telem += String(g_us_left, 2) + ",";
    telem += String(g_us_center, 2) + ",";
    telem += String(g_us_right, 2) + ",";
    telem += String(g_us_side, 2) + ",";
    telem += String(encL) + ",";
    telem += String(encR) + ",";
    telem += "0.0,";
    telem += (isEstop ? "1" : "0");
    telem += "*\n";

    Serial2.print(telem);
    Serial.print(telem); // Mirror to USB serial for debugging
  }
}
