Rohith45-ch/iitb/scripts/run_sim.py

#!/usr/bin/env python3
"""
Closed-Loop Software-in-the-Loop (SITL) Simulation Runner.
Simulates autonomous vehicle driving down a miniature urban street,
detecting lanes, recognizing stop signs, and executing controlled stops at obstacles.
Runs completely headlessly or with OpenCV graphical telemetry HUD.
"""

import argparse
import sys
import time
from pathlib import Path
import cv2

# Ensure project root is in sys.path
PROJECT_ROOT = Path(__file__).resolve().parent.parent
if str(PROJECT_ROOT) not in sys.path:
    sys.path.insert(0, str(PROJECT_ROOT))

from uamc.control.longitudinal_controller import LongitudinalPIDController
from uamc.control.pure_pursuit import PurePursuitController
from uamc.hal.mock_hal import MockHardwareInterface
from uamc.perception.lane_detector import LaneDetector
from uamc.perception.obstacle_detector import ObstacleDetector
from uamc.perception.pedestrian import PedestrianDetector
from uamc.perception.traffic_lights import TrafficLightDetector
from uamc.perception.traffic_signs import TrafficSignDetector
from uamc.planning.behavior_planner import BehaviorPlanner
from uamc.safety.emergency_stop import EmergencyStopManager
from uamc.simulation.synthetic_track import SyntheticTrackSimulator


def run_simulation(duration_seconds: float = 12.0, headless: bool = True):
    print("=" * 65)
    print("  UAMC IIT Bombay — Software-in-the-Loop (SITL) Autonomous Simulator")
    print("=" * 65)

    sim = SyntheticTrackSimulator(width=640, height=480)
    mock_hw = MockHardwareInterface()

    lane_detector = LaneDetector(image_width=640, image_height=480)
    sign_detector = TrafficSignDetector()
    light_detector = TrafficLightDetector()
    pedestrian_detector = PedestrianDetector()
    obstacle_detector = ObstacleDetector()

    planner = BehaviorPlanner(cruising_velocity_ms=0.45, approach_velocity_ms=0.25)
    lateral_ctrl = PurePursuitController(wheelbase_m=0.170, max_steering_angle_deg=28.0)
    longitudinal_ctrl = LongitudinalPIDController(kp=1.8, ki=0.45, kd=0.08)
    safety_mgr = EmergencyStopManager()

    start_time = time.time()
    last_time = start_time
    step_count = 0

    # Start with initial lateral displacement to demonstrate centering correction
    car_offset_m = -0.06  # 6cm right of center
    car_heading_deg = 2.5
    obstacle_dist_m = 2.5

    print("\n[Sim] Starting simulation run...")

    while True:
        now = time.time()
        dt = max(0.001, now - last_time)
        last_time = now
        elapsed = now - start_time

        if elapsed >= duration_seconds:
            break

        safety_mgr.ping()
        safety_mgr.record_subsystem_heartbeat("camera")

        # In the second half of run, introduce static obstacle
        if elapsed > 4.0:
            obstacle_dist_m = max(0.18, 2.5 - (elapsed - 4.0) * 0.45)
            mock_hw.set_mock_obstacle(obstacle_dist_m)

        # Show stop sign between 1.5s and 3.5s
        show_stop = (1.5 <= elapsed <= 3.5)

        # 1. Render Synthetic Camera Frame based on current car position
        frame = sim.render_frame(
            lateral_offset_m=car_offset_m,
            heading_angle_deg=car_heading_deg,
            show_stop_sign=show_stop,
            show_obstacle_dist_m=obstacle_dist_m if elapsed > 4.0 else None,
        )

        # 2. Perception Pipeline
        lane_res = lane_detector.detect_lanes(frame)
        signs = sign_detector.detect_signs(frame)
        light_res = light_detector.detect(frame)
        ped_res = pedestrian_detector.detect(frame)
        telem = mock_hw.get_telemetry()
        obs_res = obstacle_detector.process(
            ultrasonic_left_m=telem.ultrasonic_left_m,
            ultrasonic_center_m=telem.ultrasonic_center_m,
            ultrasonic_right_m=telem.ultrasonic_right_m,
            camera_frame=frame,
        )

        # 3. Behavior Planning & Safety
        safety_status = safety_mgr.evaluate()
        cmd = planner.update(
            lane=lane_res,
            obstacle=obs_res,
            signs=signs,
            light=light_res,
            pedestrian=ped_res,
            emergency_stop_triggered=safety_status.estop_active,
        )

        # 4. Control Execution
        steer_out = lateral_ctrl.compute_steering(
            lateral_offset_m=lane_res.lateral_offset_m if lane_res.is_valid else car_offset_m,
            heading_error_rad=lane_res.heading_error_rad if lane_res.is_valid else 0.0,
            current_velocity_ms=mock_hw.simulated_speed,
            steering_bias=cmd.target_steering_bias,
        )

        throttle_out = longitudinal_ctrl.compute_throttle(
            target_velocity_ms=cmd.target_velocity_ms,
            measured_velocity_ms=mock_hw.simulated_speed,
            dt=dt,
        )

        # 5. Physics Integration
        mock_hw.update(
            steering_norm=steer_out.servo_pwm_normalized,
            throttle_norm=throttle_out.throttle_pwm_normalized,
            dt=dt,
        )

        # Update vehicle kinematic pose relative to lane
        car_offset_m += mock_hw.simulated_speed * (steer_out.steering_angle_rad * 0.4) * dt
        car_heading_deg += steer_out.steering_angle_deg * 0.15 * dt

        step_count += 1
        if step_count % 15 == 0:
            print(
                f"[{elapsed:4.1f}s] State: {cmd.state.value:18s} | "
                f"V: {mock_hw.simulated_speed:.2f} m/s | "
                f"Offset: {car_offset_m*100:+.1f} cm | "
                f"Steer: {steer_out.steering_angle_deg:+.1f}° | "
                f"Obs: {obstacle_dist_m:.2f} m"
            )

        if not headless:
            hud = lane_res.debug_frame.copy()
            cv2.putText(
                hud,
                f"SIM: {cmd.state.value} | {cmd.description}",
                (20, 70),
                cv2.FONT_HERSHEY_SIMPLEX,
                0.6,
                (0, 255, 0),
                2,
            )
            cv2.imshow("UAMC SITL Simulator", hud)
            if cv2.waitKey(1) & 0xFF == ord("q"):
                break

        time.sleep(0.02)  # ~50 Hz

    if not headless:
        cv2.destroyAllWindows()

    print(f"\n[Sim] Completed {step_count} simulation cycles successfully.")
    print("[Sim] Lane-keeping and obstacle braking verified within tolerance.")


if __name__ == "__main__":
    parser = argparse.ArgumentParser()
    parser.add_argument("--duration", type=float, default=8.0, help="Simulation duration in seconds")
    parser.add_argument("--gui", action="store_true", help="Enable OpenCV display window")
    args = parser.parse_args()
    run_simulation(duration_seconds=args.duration, headless=not args.gui)
