Rohith45-ch/iitb/(commit log)

2026-10-29 feat(esp32-rpi): dual-core FreeRTOS ESP32 controller, wiring guide, and qualification video recorder
2026-10-29 feat(ai-models): add EdgeAIDetector via cv2.dnn, model fetcher script, and ESP32 TinyML motion classifier
2026-10-29 feat(ai): add NVIDIA PilotNet end-to-end steering ONNX model and controller
2026-10-29 feat(firmware): integrate ultrasonic outlier filter and TinyML motion classifier into ESP32 FreeRTOS tasks
2026-10-29 feat(config): isolate Raspberry Pi and ESP32 tuning parameters into dedicated configuration blocks with calibration guide
2026-10-29 feat(bridge): implement virtual ESP32 simulation loopback in serial bridge and add pre-flight system verification script
2026-10-30 docs: add complete hardware+software integration guide for Pi5+ESP32+ESC
2026-10-30 feat(ai-esc): add native ESC 50Hz PWM control and live AI vision benchmarking tool
2026-10-30 feat(orchestrator): add one-click hardware bring-up and interactive calibration suite
2026-10-30 docs: sync ultrasonic pin numbers with esp32_config.h
2026-10-31 docs: add complete 3D-printing multi-deck chassis and component architecture blueprint
2026-10-31 docs: clarify single front-center ultrasonic sensor setup for Round 1
2026-10-31 docs: clean up all remaining references to multi-sonar sensors, set to 1 single sensor
2026-10-31 docs: complete repository audit - standardize on Pi5, ESC throttle, and single front ultrasonic sensor
2026-10-31 docs: add MG995 standard servo dimensions and resolve E-Stop pin collision
2026-10-31 docs: lock hardware configuration to Micro Servo 9g and 2500-3500mAh LiPo power
2026-10-31 docs: complete pin-to-pin alignment and variable name sync across all documentation
2026-10-31 docs: complete overhaul of COMPLETE_GUIDE.md master manual with unified hardware, pinouts, and CAD specs
2026-10-31 fix: correct all Pi 4B→Pi 5, TB6612/3S-LiPo→ESC/2S-LiPo errors found in PDF audit
    PDF Wiring_and_Pin_Map.pdf cross-checked pin-by-pin against firmware.
    Fixes applied:
    - ESP32_RPI_WIRING_GUIDE.md: Pi 4B→Pi 5, 3S/TB6612 block→2S LiPo/ESC
    - PHYSICAL_BRINGUP_AND_INTEGRATION_GUIDE.md: Pi 4B→Pi 5, SSH login corrected, 7.4V/11.1V→7.4V 2S LiPo
    - README.md: Pi 4B→Pi 5 in diagram and badge
    - TECHNICAL_DESIGN_DOCUMENT.md: Pi 4B→Pi 5 (8GB), 7.4V/11.1V→7.4V 2S LiPo
    - SIMILAR_PROJECTS_RESEARCH.md: Our row corrected Pi 4B→Pi 5 (other teams' rows unchanged)
    - config/rpi_tuning.py: header comment Pi 4B→Pi 5
    - scripts/export_pilotnet_onnx.py: comment Pi 4B→Pi 5
    PDF pin table confirme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
2026-10-31 fix(hardware-redesign): align 100% with Wiring_and_Pin_Map.pdf specifications
    - Firmware & Pinout (esp32_config.h, esp32_vehicle_controller.ino):
    * Set USE_ESC_MOTOR_DRIVER = 0 for L298N dual H-bridge
    * GPIO 19: L298N ENA+ENB (20 kHz PWM speed control)
    * GPIO 22: L298N IN1+IN3 (Direction A, HIGH=forward)
    * GPIO 23: L298N IN2+IN4 (Direction B, LOW=forward)
    * GPIO 18: Micro Servo 9g (SG90/MG90S, 50 Hz, 1000-2000 us)
    * GPIO 5 (Trig) & GPIO 35 (Echo via 1k/2k divider): single front-center HC-SR04
    * GPIO 27: Physical E-Stop button with INPUT_PULLUP (active-LOW)
    * Added SINGLE_CENTER_SONAR_ONLY define to bypass floating sonar pins
    * Added ENABLE_WHEEL_ENCODERS define to avoid flo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
2026-10-31 docs(3d-printing): redesign mechanical chassis architecture for 170mm wheelbase build
    - Location: docs/3D_PRINTING_CHASSIS_AND_COMPONENTS_ARCHITECTURE.md
    - Updated with exact millimeter CAD specs, pocket tolerances, and fastener schedules
    - Tailored to: 170 mm wheelbase chassis, L298N + 2x TT motors, dual buck converters (7V/5V),
    3S LiPo 2200mAh floor cradle, Micro Servo 9g pocket, single front HC-SR04 pod,
    and 18-degree elevated camera mast for Raspberry Pi 5 + Pi Camera Rev 1.3
2026-11-07 docs: align chassis and shared Pi-servo power design
2026-11-08 docs: update wiring and setup guides for power distribution and component connections
