Rohith45-ch/iitb/(notices)

Notices in the files:
README.md:
License: MIT
